CamdenMontgomery/SwitchWay/Hardware/switchway_bb.jpg

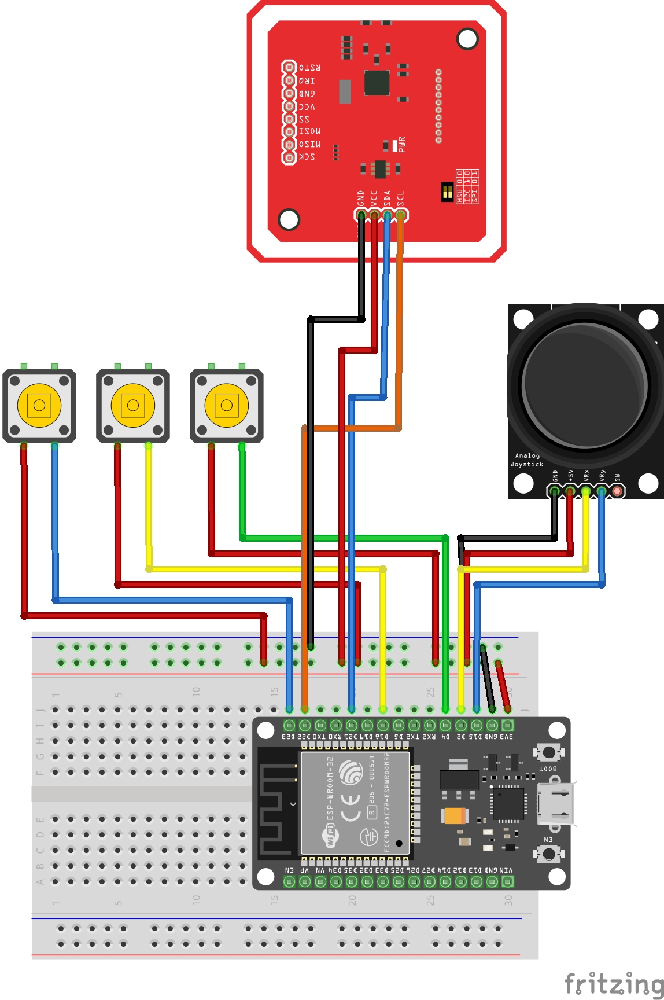
Hardware/switchway_bb.jpg
