CamdenMontgomery/SwitchWay/Hardware/switchway_exploded_view.PNG

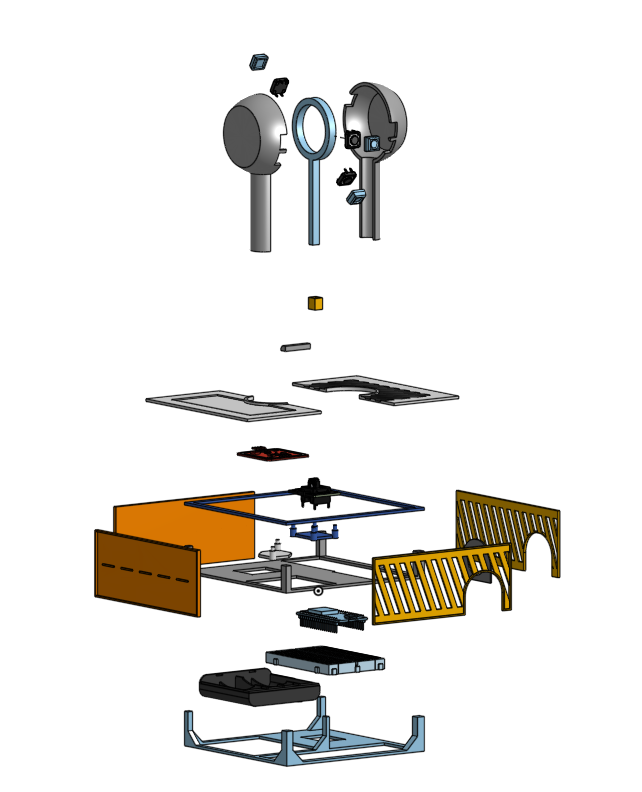
Hardware/switchway_exploded_view.PNG
